erichardy/GestBat/README.md

# GestBat
Boîtier d'aide à la mise en charge des batteries de mon Vélo à Assistance Electrique (VAE)
