erichardy/GestBat/doc/intro.rst

.. include:: links.rst

Introduction
============

La documentation du constructeur de mon vélo à assistance électrique (VAE) indique clairement
qu'il est préférable, après chaque utilisation, de laisser la batterie refroidir
environ **30mn** avant de la remettre à recharger.

Si on veut respecter cette consigne, il faut penser à recharger la batterie relativement longtemps
après l'utilisation. Il peut être utile de se faire aider en utilisant une alarme
(téléphone, minuterie du four, etc...) comme rappel, sous peine d'avoir une batterie non
chargée lors de la prochaine utilisation du VAE.

Ce boîtier a pour fonction de ne pas avoir à se soucier de cette `contrainte`, il permet de
mettre en place la recharge de la batterie qui commencera de façon différée.

D'autre part, tout chargeur branché, même quand il ne remplit pas sa fonction de `chargeur`,
c'est-à-dire quand la charge est terminée, **continue à tirer du courant de façon totalement
inutile !**

En l'occurence, le chargeur de mon VAE consomme 22mA (soit **plus de 5 Watts !**) une fois la charge terminée, que
la batterie soit restée branchée ou non. Voir en annexe une remarque plus générale à ce sujet...

.. note::
    Ce constat s'applique aussi à tous les chargeurs de tablettes et autres téléphones mobiles qui,
    trop souvent, sont laissés branchés au secteur 24 heures sur 24.

En résumé, les avantages procurés par ce boîter :

* je ne me soucie plus de la question de délai de mise en charge après utilisation de mon VAE :
  dès mon retour à la maison, je mets la batterie en place avec le boîtier et la charge commence après le
  délai de rigueur, par défaut **30mn**.

* quand la charge est terminée, les relais contenus dans le boîtier éteignent complètement tout ce
  dispositif. Aucun courant n'est donc consommé quand la charge est terminée, et le chargeur,
  déconnecté du secteur, ne chauffe plus.

* si besoin, je peux régler un délai de début de charge à une valeur différence de la valeur par défaut.

**Au jour où ces lignes sont écrites (juin 2026), j'utilise ce boîtier depuis plusieurs mois de façon régulière.**

**Je suis TRÈS satisfait de mon appareil**
