erichardy/GestBat/doc/links.rst

.. _Sphinx: http://sphinx-doc.org/
.. _Sphinx-config: http://www.sphinx-doc.org/en/1.4.8/config.html
.. _RST: http://docutils.sourceforge.net/docs/user/rst/quickref.html
.. _reStructuredText Markup Specification: https://docutils.sourceforge.io/docs/ref/rst/restructuredtext.html
.. _SphinxAutobuild: https://pypi.org/project/sphinx-autobuild/

.. _KeyBindingVSC: https://code.visualstudio.com/docs/getstarted/keybindings

.. _SnipsetsDansVSC: https://docs.typo3.org/m/typo3/docs-how-to-document/master/en-us/ToolsEditRest/Index.html

.. _reStructuredText Syntax highlighting: https://github.com/trond-snekvik/vscode-rst#readme

.. _sketch de l'arduino sur github: https://github.com/erichardy/thermostat/blob/master/src/main.cpp

.. _dépôt sur github: https://github.com/erichardy/thermostat

.. In-system programming (ISP), or also called in-circuit serial programming (ICSP)
.. _Arduino as ISP and Arduino Bootloaders: https://www.arduino.cc/en/Tutorial/BuiltInExamples/ArduinoISP
.. _Upload using Programmer: https://docs.platformio.org/en/latest/platforms/atmelavr.html?highlight=isp#upload-using-programmer
.. _Broche ICSP, qu'est-ce que c'est?: https://qastack.fr/arduino/40098/icsp-pin-what-is-it-actually
.. _Interruptions et variables partagées - Utiliser volatile, cli, sei, SREG: https://www.youtube.com/watch?v=55YEZppz7p4
.. _Eviter les rebonds: https://www.youtube.com/watch?v=ftdqUflYG3Y&list=PLuQznwVAhY2V7Uh0aHOgBvaiqRw9VeCis&index=9&t=520s

.. _hystérésis: https://fr.wikipedia.org/wiki/Hyst%C3%A9r%C3%A9sis

.. _Raspberry Pi Pico: https://www.raspberrypi.com/documentation/microcontrollers/microcontroller-chips.html
.. _RPI-Pico: https://www.raspberrypi.com/documentation/microcontrollers/microcontroller-chips.html
.. _MicroPython: https://micropython.org/

.. un exemple de doc : cd ~/SSD/Dev-OLD/ubl.tebl/docs

.. cd ~/Documents/PlatformIO/Projects/thermostat

.. sphinx-autobuild . ./_build/html

.. http://127.0.0.1:8000
