erichardy/GestBat/gestBat_doc.odt

Système d’aide à la mise en charge des batteries de VAE

### Fonctionnalités

- boîtier connecté au secteur en permanence mais ne tirant aucun courant tant qu’il n’est pas en cours d’utilisation
- branchement de la batterie sur le boîtier
- configuration du délai de début de la charge. Le délai par défaut étant de 30mn
- démarrage de la recharge après un délai déterminé
- détection en temps réel du courant secteur
- coupure de l’alimentation de l’ensemble quand le courant détecté est au niveau de celui qui correspond à l’arrêt de la charge (le chargeur, même quand la charge est terminée, continue de tirer du courant)

### Usage

1. on branche la batterie sur le boîtier
2. on appuie sur le(s) bouton(s) de démarrage pendant quelques secondes le temps que le microcontrôleur active le(s) relai(s) pour l’alimentation générale ; un son et une LED signalent que le démarrage du système est effectif
3. réglage du délai de début de charge
4. la charge débute quand le délai donné est expiré
5. fin de charge : émission éventuelle d’un son pour signaler la fin de la charge
6. arrêt automatique complet du système provoqué par le microcontrôleur qui actionne le(s) relai(s) général/aux qui coupe(nt) toute l’alimentation

### Fonctionnalités implémentées dans le Raspberry Pi Pico

- Au démarrage : activer les 2 relais de l’alimentation générale et envoyer un beep quand le système est démarré
- gérer la configuration du délai de démarrage de la charge. Cette config peut être faite soit avec des boutons préconfigurés (30mn, 20mn, 10mn, 0mn), ou des appuis successifs sur un bouton ‘+’ et un bouton ‘-’, ou avec un rotatif + clic pour valider
- gérer l’affichage sur un écran à cristaux liquides
- activer le relais qui permet l’alimentation du chargeur
- calculer le courant
- couper le relais d’alimentation du chargeur

Fonctions à implémenter :

- activer et dé-activer un relais SSR
- émettre un BEEP ou autre son
- affichage sur écran cristaux liquides : https://www.freva.com/fr/connecter-un-ecran-lcd-a-un-raspberry-pi-pico/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 ou https://www.youtube.com/watch?v=bXLgxEcT1QU&ab_channel=NerdCave
- acquérir des données :en provenance du transformateur de courant et du « capteur » de tension
- étalonner les mesures : courant et tension

Annexe 1 : diverses pistes

- Peut-être le « Horloge en temps réel (RTC) Microchip série I2C, SOIC, 5.5 V, 64B RAM, 8 broches » (à https://ma.rsdelivers.com/product/microchip/mcp79410-i/sn/horloge-en-temps-reel-rtc-microchip-serie-i2c-soic/7263949) pour, éventuellement, stocker les opérations de charge avec les dates…
