erichardy/GestBat/doc/IMGA0045.JPG

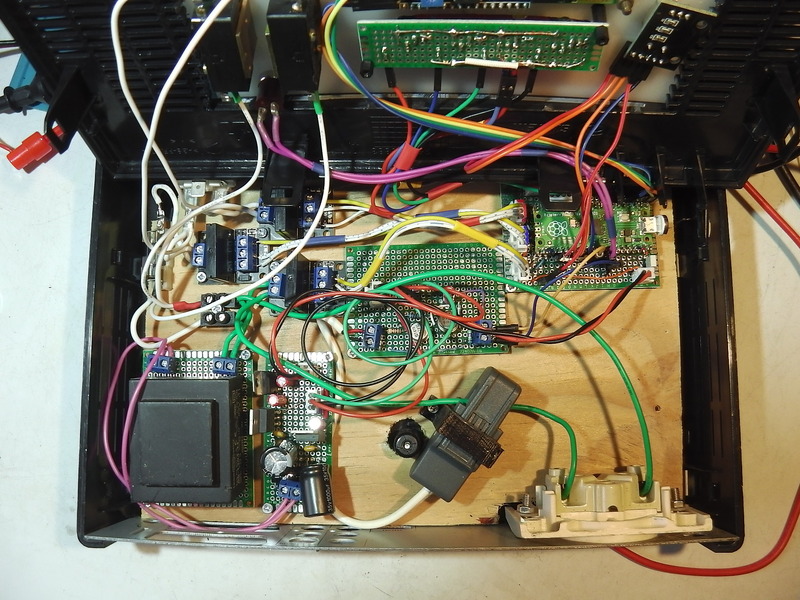
doc/IMGA0045.JPG
