erichardy/GestBat/doc/IMGA0046.JPG

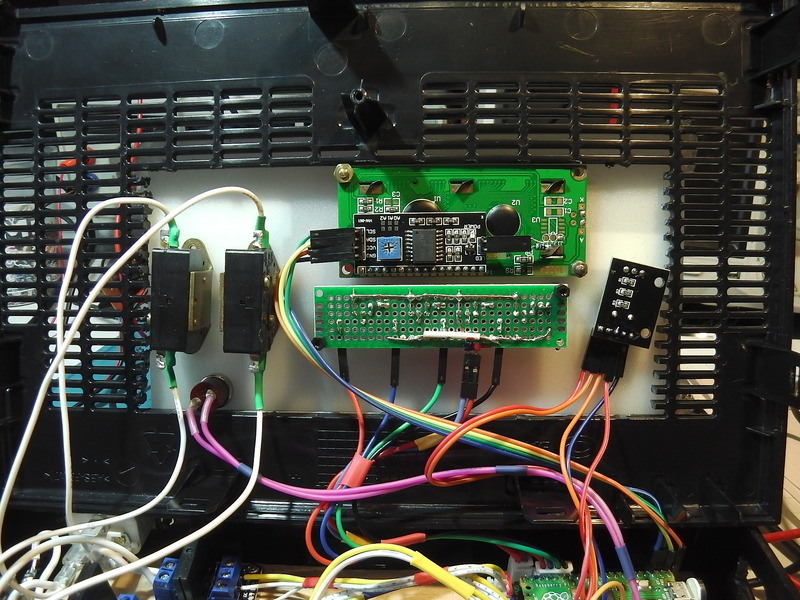
doc/IMGA0046.JPG
