erichardy/GestBat/doc/IMGA0047.JPG

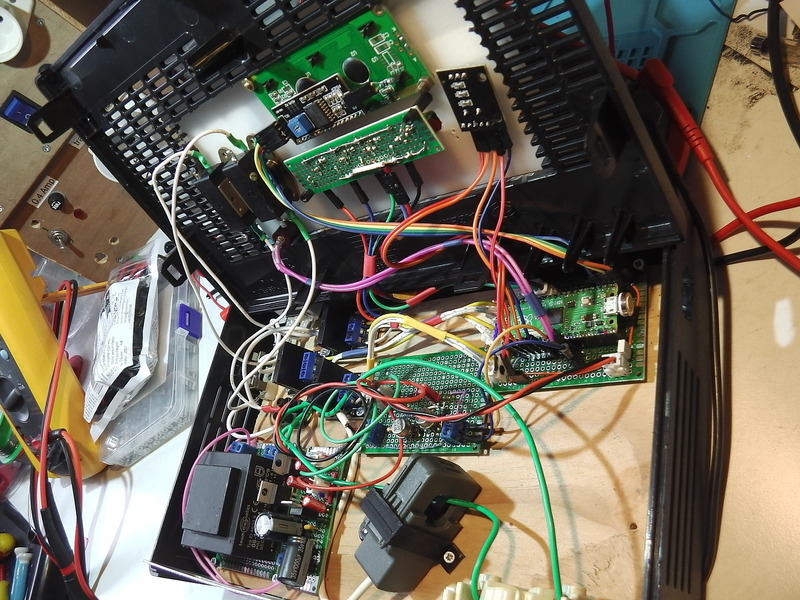
doc/IMGA0047.JPG
