erichardy/GestBat/doc/IMGA0048.JPG

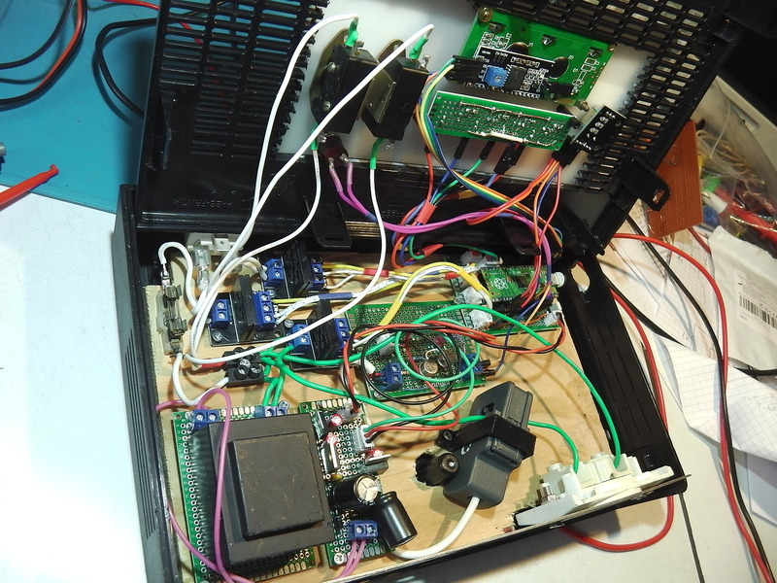
doc/IMGA0048.JPG
