erichardy/GestBat/doc/IMGA0049.JPG

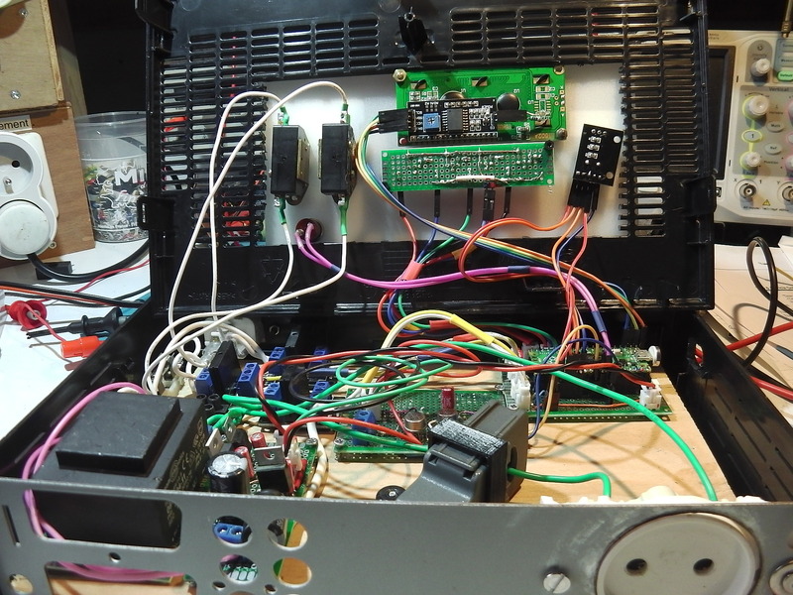
doc/IMGA0049.JPG
