erichardy/GestBat/Kicad/GestBat.kicad_pcb

## KiCad design Kicad/GestBat.kicad_pcb (2026-06-08)

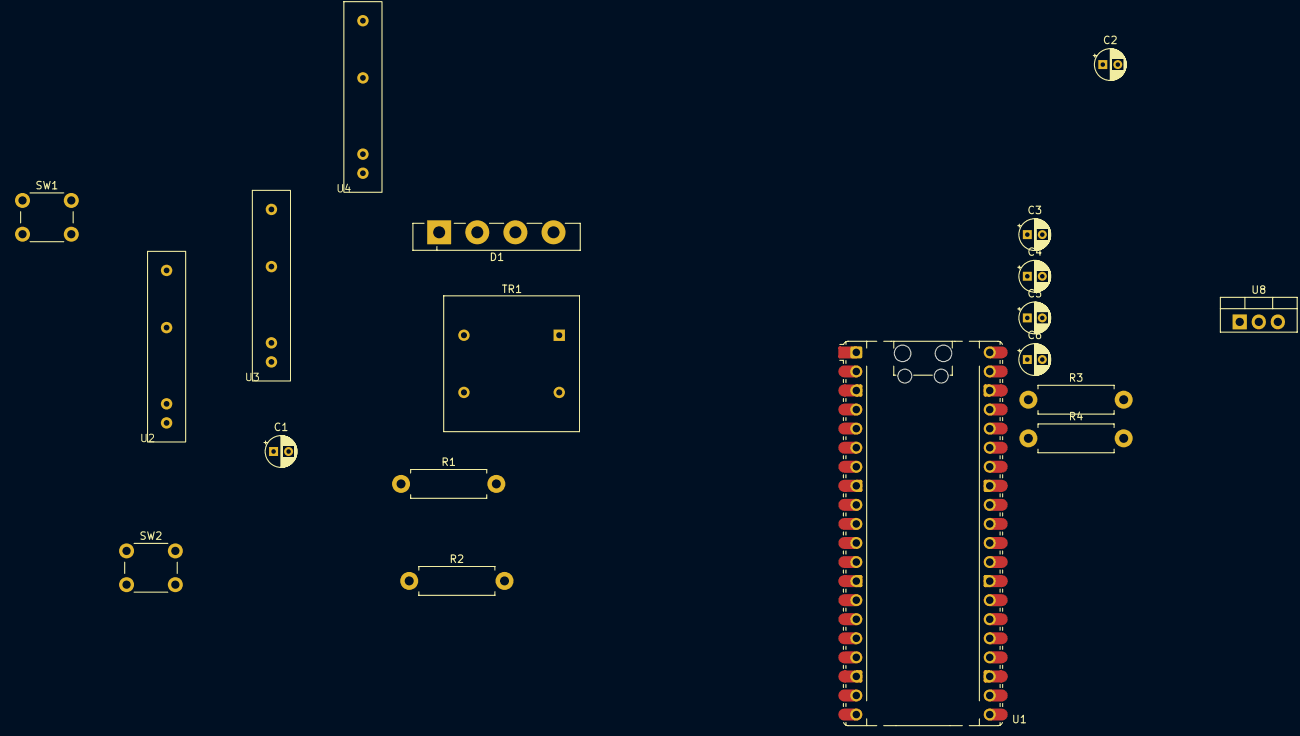
[picture p8: board GestBat.kicad_pcb from above]

Board: 2 copper layers, 19 parts (0 on the bottom side), 14 nets, no tracks yet.

Parts:
C1, C5, C6: c=10u; CP_Radial_D4.0mm_P2.00mm
C2: c=1u; CP_Radial_D4.0mm_P2.00mm
C3, C4: c=1000u; CP_Radial_D4.0mm_P2.00mm
D1: GBU4M; Diode_Bridge_Vishay_GBU
R1: r=1M; R_Axial_DIN0411_L9.9mm_D3.6mm_P12.70mm_Horizontal
R2: r=6.8k; R_Axial_DIN0411_L9.9mm_D3.6mm_P12.70mm_Horizontal
R3: r=3.3k; R_Axial_DIN0411_L9.9mm_D3.6mm_P12.70mm_Horizontal
R4: r=1k; R_Axial_DIN0411_L9.9mm_D3.6mm_P12.70mm_Horizontal
SW1, SW2: SW_Push; SW_PUSH_6mm_H5mm
TR1: TRANSF1; Transformer_NF_ETAL_P3356
U1: eh_RP2040_pico; RaspberryPi_Pico_Common_Unspecified
U2, U3, U4: G3MB-202P
U8: LM7909_TO220; TO-220-3_Vertical

Connections:
/-9: C6.2, U8.3 (VO)
/MEAS_Current: C2.1, U1.31 (GPIO26)
/MEAS_Tension: R1.2, R2.2, U1.32 (GPIO27)
/VAC1: D1.3, SW1.2, TR1.1, U2.2 (LOAD2), U4.2 (LOAD2)
/VAC2: D1.2, SW2.2, U3.2 (LOAD2)
/ctrl-LOAD: U1.24 (GPIO18), U4.4 (Plus)
/ctrl-Main1: U1.21 (GPIO16), U2.4 (Plus)
/ctrl-Main2: U1.22 (GPIO17), U3.4 (Plus)
GND: C1.2, C2.2, C3.2, C4.1, C6.1, D1.4 (-), R2.1, TR1.3, U1.13 (GND), U2.3 (Moins), U3.3 (Moins), U4.3 (Moins), U8.1 (GND)
unnamed: C1.1, D1.1 (+), R1.1
unnamed: C4.2, U8.2 (VI)
unnamed: SW2.1, U3.1 (LOAD1)
unnamed: SW1.1, U2.1 (LOAD1)
unnamed: R3.2, R4.1
